dss-loris/prototype_1/PDF Schematics/Main.pdf

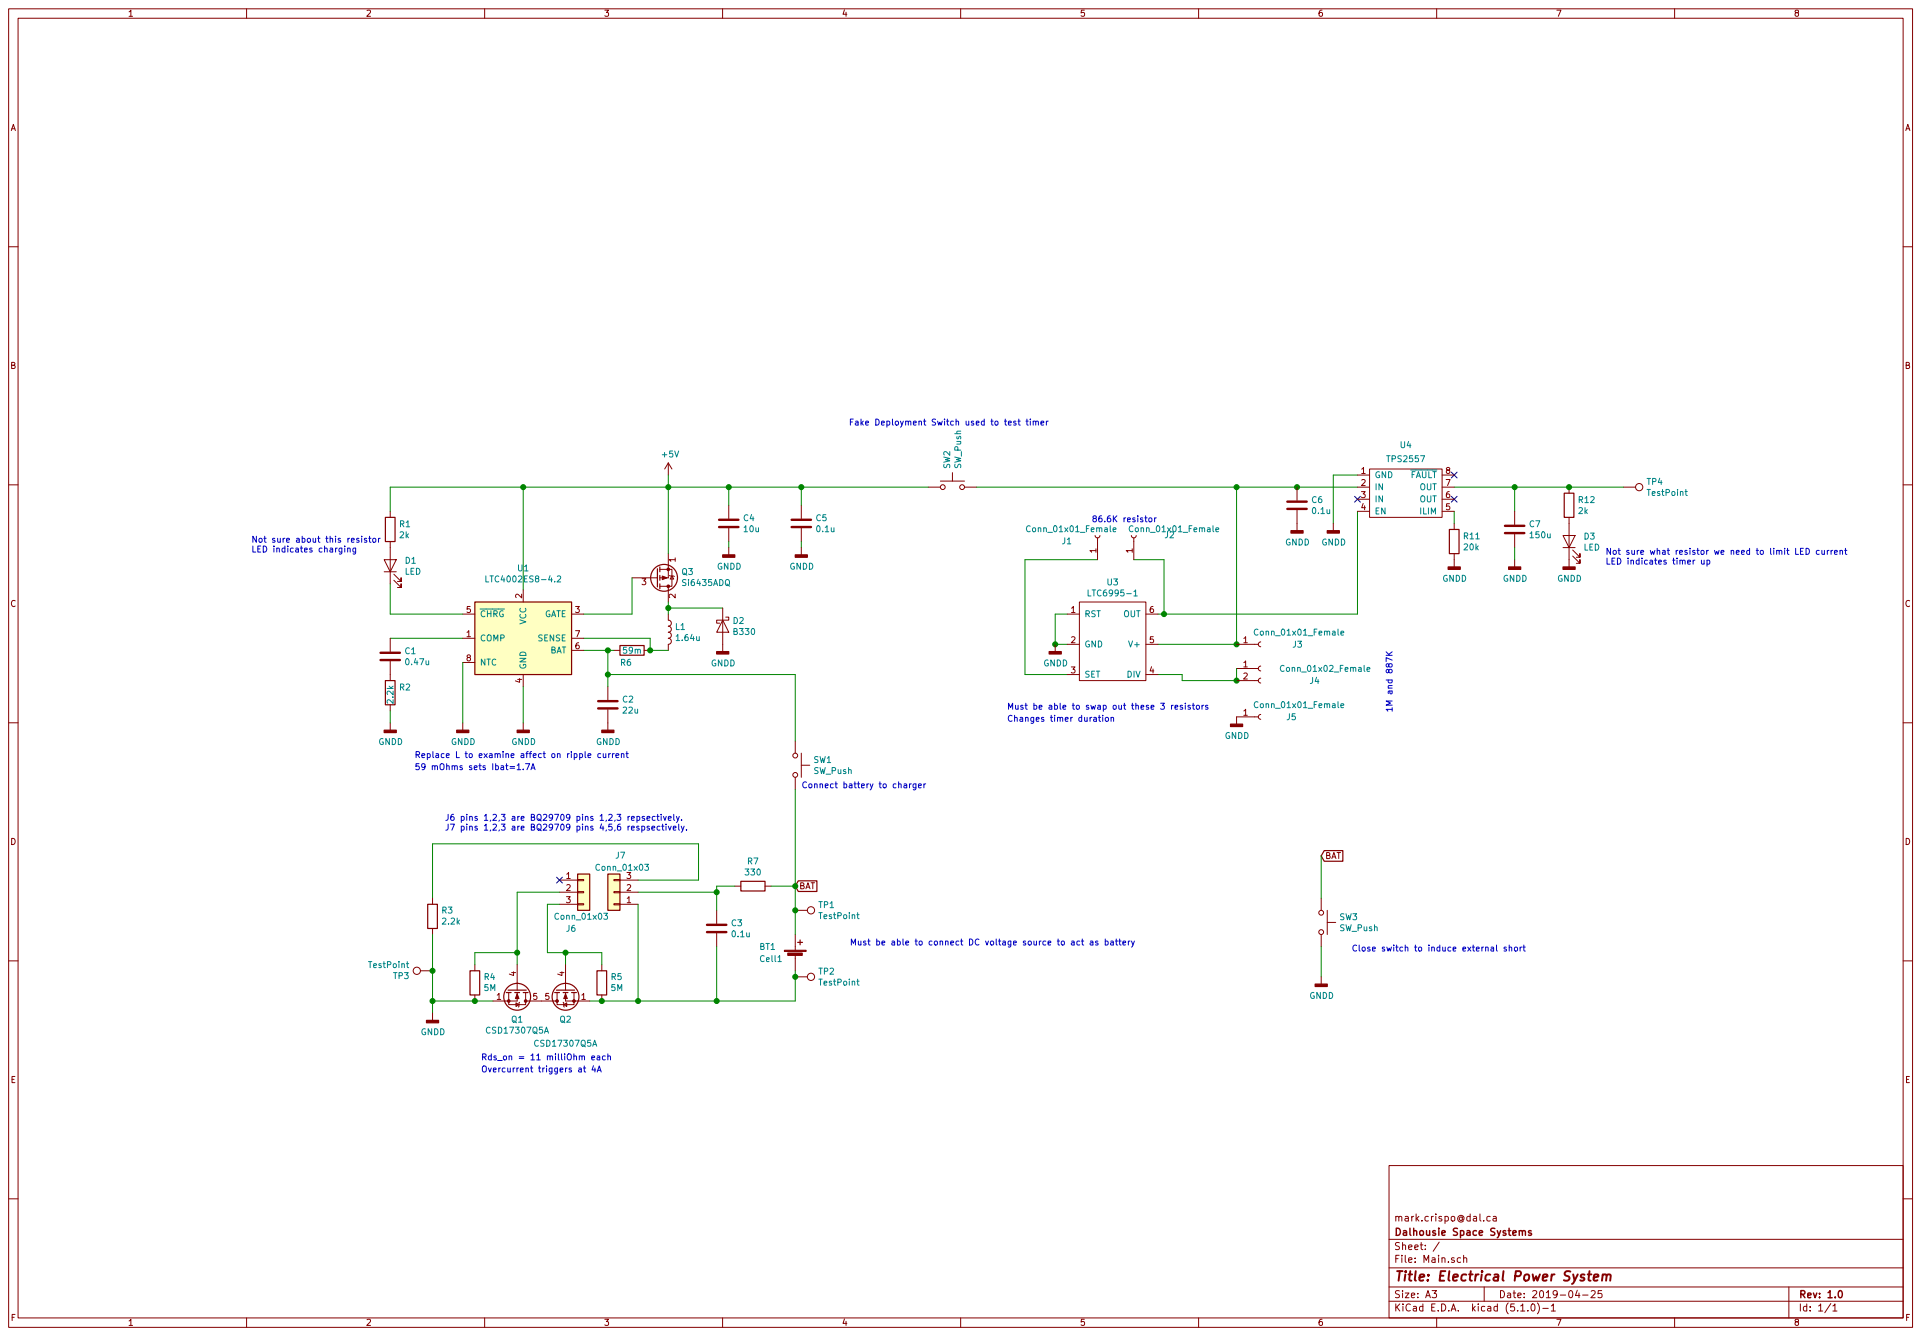
[picture p1: page 1]

LTC6995-1 Fake Deployment Switch used to test timer SW2 SW_Push

Not sure about this resistor LED indicates charging

4 CHRG 5 BAT 6 SENSE 7 NTC 8 U1

Replace L to examine affect on ripple current 59 mOhms sets Ibat=1.7A

Close switch to induce external short SW1 SW_Push Connect battery to charger

J6 pins 1,2,3 are BQ29709 pins 1,2,3 repsectively.

mark.crispo@dal.ca
File: Main.sch Sheet: / Dalhousie Space Systems

Id: 1/1 Title: Electrical Power System
