dss-loris/prototype_1/Main.kicad_pcb

## KiCad design Main.kicad_pcb (2019-07-02)

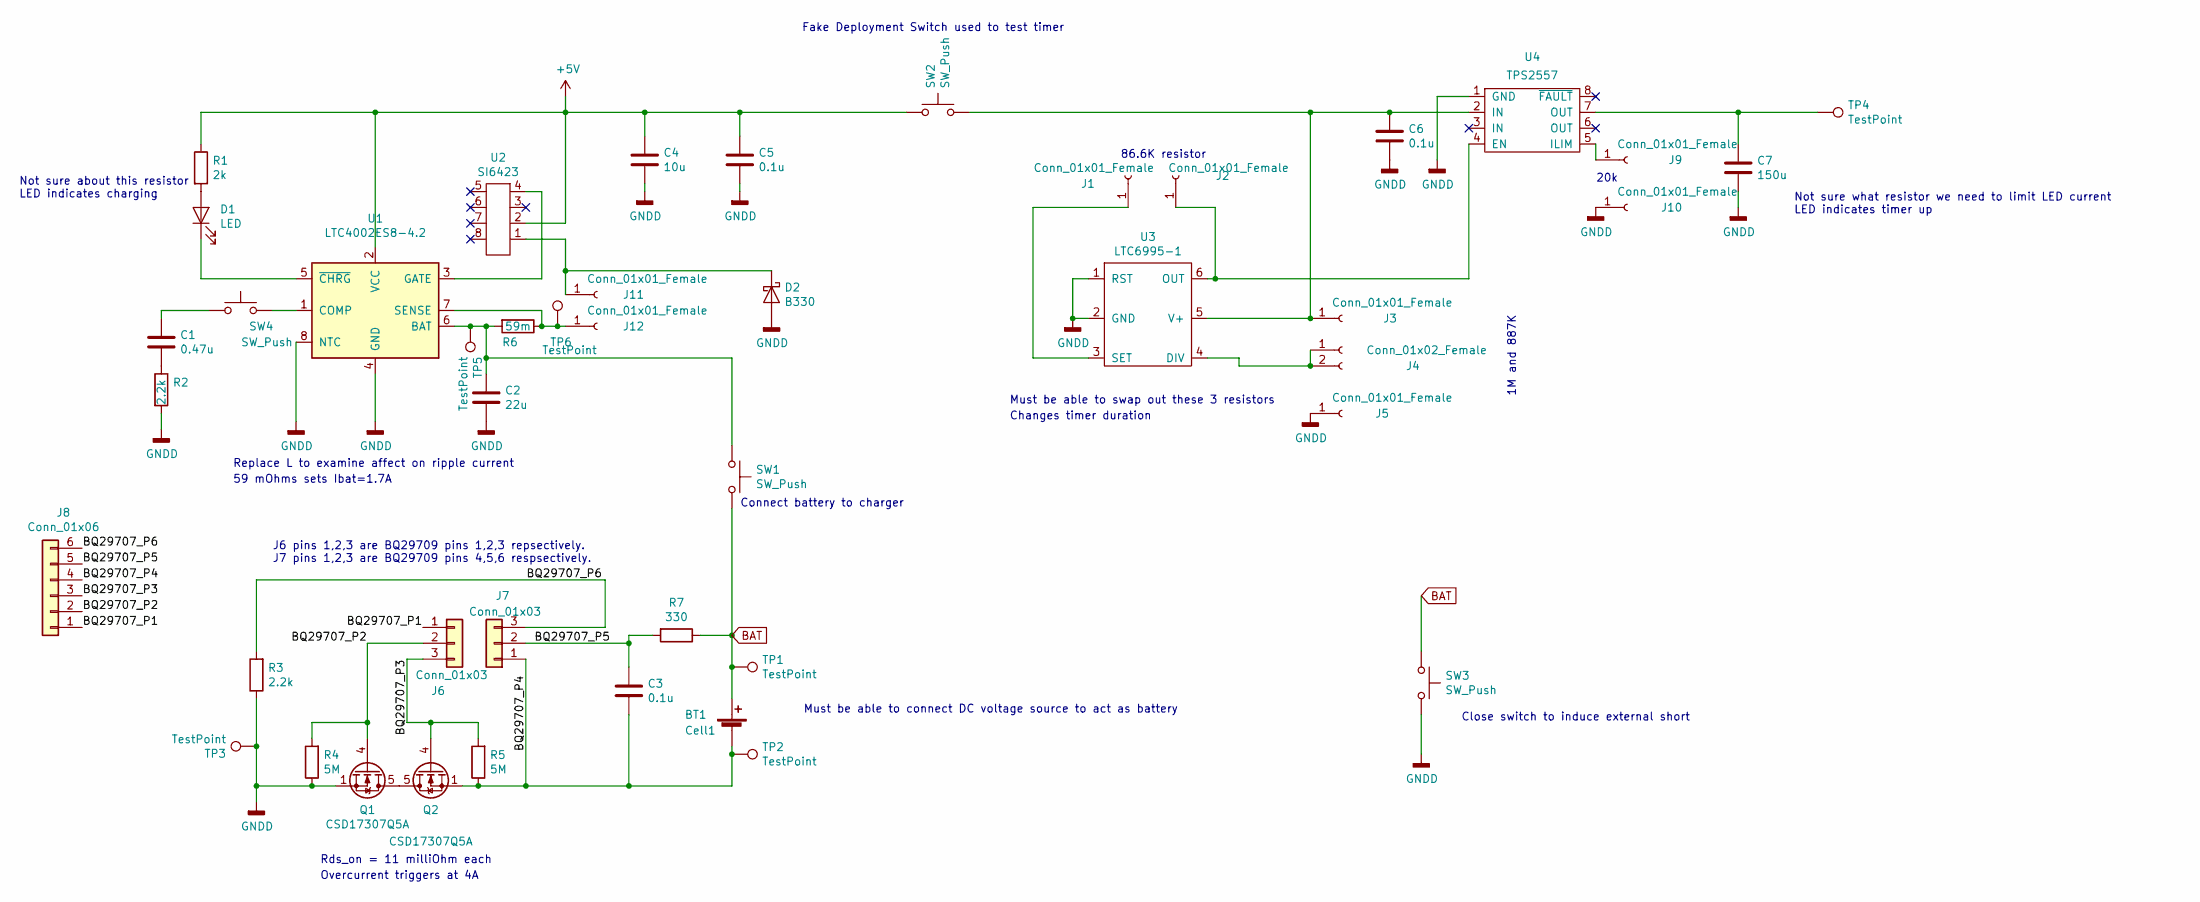
[picture p2: schematic Main.sch, Electrical Power System]

Parts:
BT1: Cell1; BatteryHolder_Keystone_1042_1x18650
C1: 0.47u; C_1206_3216Metric
C2: 22u; C_1206_3216Metric
C3, C5, C6: 0.1u; C_1206_3216Metric
C4: 10u; C_1206_3216Metric
C7: 150u; C_1206_3216Metric
D1: LED; LED_1206_3216Metric
D2: B330; D_SMC
J1, J2, J3, J5, J9, J10, J11, J12: Conn_01x01_Female; PinSocket_1x01_P2.00mm_Vertical
J4: Conn_01x02_Female; PinSocket_1x02_P2.00mm_Vertical
J6, J7: Conn_01x03; PinSocket_1x03_P2.54mm_Vertical
J8: Conn_01x06; PinHeader_1x06_P2.00mm_Vertical
Q1, Q2: CSD17307Q5A; TDSON-8-1
R1: 2k; R_1206_3216Metric
R2, R3: 2.2k; R_1206_3216Metric
R4, R5: 5M; R_1206_3216Metric
R6: 59m; R_1206_3216Metric
R7: 330; R_1206_3216Metric
SW1, SW2, SW3, SW4: SW_Push; SW_DIP_SPSTx01_Slide_6.7x4.1mm_W6.73mm_P2.54mm_LowProfile_J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
TP1, TP2, TP3, TP4, TP5, TP6: TestPoint; PinHeader_1x01_P2.00mm_Vertical
U1: LTC4002ES8-4.2; SOIC-8_3.9x4.9mm_P1.27mm
U2: SI6423; TSSOP-8_4.4x3mm_P0.65mm
U3: LTC6995-1; TSOT-23-6_HandSoldering
U4: TPS2557

Connections:
+5V: C4.1, C5.1, R1.1, SW2.1, U1.2 (VCC), U2.2
/BQ29707_P1: J6.1, J8.1
/BQ29707_P2: J6.2, J8.2, Q1.4 (G), R4.2
/BQ29707_P3: J6.3, J8.3, Q2.4 (G), R5.2
/BQ29707_P4: BT1.2 (-), C3.2, J7.1, J8.4, Q2.1 (S), Q2.2 (S), Q2.3 (S), R5.1, TP2.1
/BQ29707_P5: C3.1, J7.2, J8.5, R7.2
/BQ29707_P6: J7.3, J8.6, R3.2
BAT: BT1.1 (+), R7.1, SW1.2, SW3.1, TP1.1
GNDD: C2.2, C4.2, C5.2, C6.2, C7.2, D2.2 (A), J5.1, J10.1, Q1.1 (S), Q1.2 (S), Q1.3 (S), R2.2, R3.1, R4.1, SW3.2, TP3.1, U1.4 (GND), U1.8 (NTC), U3.1 (RST), U3.2 (GND), U4.1 (GND)
unnamed: C1.1, SW4.1
unnamed: C1.2, R2.1
unnamed: C2.1, R6.2, SW1.1, TP5.1, U1.6 (BAT)
unnamed: C6.1, J3.1, SW2.2, U3.5 (V+), U4.2 (IN)
unnamed: C7.1, TP4.1, U4.7 (OUT)
unnamed: D1.1 (K), U1.5 (~CHRG~)
unnamed: D1.2 (A), R1.2
unnamed: D2.1 (K), J11.1, U2.1
unnamed: J1.1, U3.3 (SET)
unnamed: J2.1, U3.6 (OUT), U4.4 (EN)
unnamed: J4.1, J4.2, U3.4 (DIV)
unnamed: J9.1, U4.5 (ILIM)
unnamed: J12.1, R6.1, TP6.1, U1.7 (SENSE)
unnamed: Q1.5 (D), Q2.5 (D)
unnamed: SW4.2, U1.1 (COMP)
unnamed: U1.3 (GATE), U2.4

Notes on the sheet:
Must be able to swap out these 3 resistors
Fake Deployment Switch used to test timer
Rds_on = 11 milliOhm each
Overcurrent triggers at 4A
Must be able to connect DC voltage source to act as battery
Close switch to induce external short
Connect battery to charger
Changes timer duration
Not sure what resistor we need to limit LED current LED indicates timer up
Not sure about this resistor LED indicates charging
Replace L to examine affect on ripple current
59 mOhms sets Ibat=1.7A
86.6K resistor
1M and 887K
J6 pins 1,2,3 are BQ29709 pins 1,2,3 repsectively. J7 pins 1,2,3 are BQ29709 pins 4,5,6 respsectively.
20k

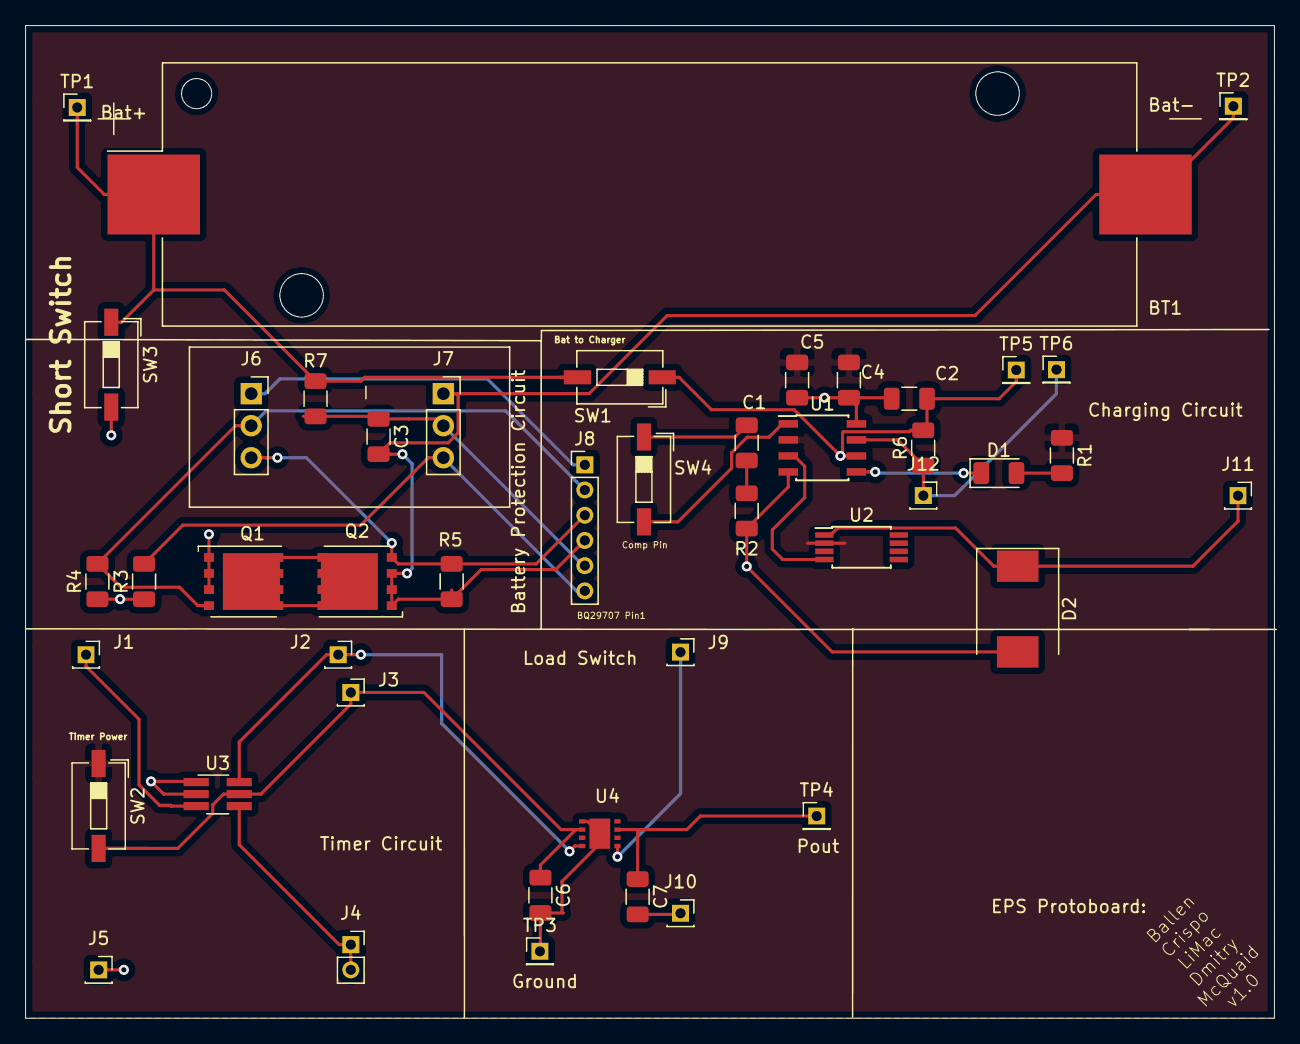
[picture p3: board Main.kicad_pcb from above]

Board: 2 copper layers, 99.1 x 78.7 mm, 45 parts (0 on the bottom side), 25 nets.
