dss-loris/prototype_1/(commit log)

2019-04-28 moved solar cell current sensor and load switch to root sheet
    [Main.sch, SPV1040.sch, SolarRegulator.sch]
2019-04-28 added schematic for Batt, BCR, and PDU
    [Main.sch, SPV1040.sch, SolarRegulator.sch]
2019-04-29 added current sensing circuit and 5v/3.3v voltage monitoring
    [Current Sesnsing.sch, Main.sch, SPV1040.sch, SolarRegulator.sch]
2019-05-13 Added libraries
    Addition of 555 & 4.2-5V Regulator libraries
2019-05-21 Imported 5V Regulator and 30 minute timer
    Added libraries to the working libraries in the main project. Also imported the 4.2-5VDC regulator and 30 minute timer schematics.
    [Main.sch, SPV1040.sch, SolarRegulator.sch]
2019-05-24 changed msp430
    [Current Sesnsing.sch, Low_pulser.sch, Main.sch, SPV1040.sch, SolarRegulator.sch]
2019-05-28 Added two more batteries for 4P configuration, added TI BQ297xx battery protection IC and PTC resettable fuse
    [BatteryCell.sch, Current Sesnsing.sch, Main.sch, SPV1040.sch, SolarRegulator.sch]
2019-05-29 added system switch to negative terminal of battery pack. moved BDR and BCR to hierarchical sheets for improved readability
    [BCR.sch, BDR.sch, Current Sesnsing.sch, Low_pulser.sch, Main.sch, SPV1040.sch, SolarRegulator.sch]
2019-05-31 Added more hierarchical sheets to improve readability, restructured the main schematic, and added ideal diode betewen BCR and BDR
    [3.3V_reg.sch, BatteryCell.sch, Current Sesnsing.sch, Low_pulser.sch, Main.sch, SPV1040.sch, SolarRegulator.sch]
2019-06-03 Added 5MOhm resistor across gatesource of power mosfet in battery cell protection schematic
    [BatteryCell.sch]
2019-06-05 rearranged op amps
    [BatteryCell.sch, Main.sch, SPV1040.sch]
2019-06-10 added new timer circuit and changed deployment switch architecture
    [3.3V_reg.sch, BCR.sch, BDR.sch, BatteryCell.sch, Current Sesnsing.sch, Main.sch, SPV1040.sch, SolarRegulator.sch]
2019-06-13 updated MOSFET model in battery cell protection schematic. Refused PTC fuse due to uncertain behaviour under conformal coating and in vacuum.
    [BatteryCell.sch]
2019-06-13 test commit
    [3.3V_reg.sch, BCR.sch, BDR.sch, BatteryCell.sch, Main.sch, SPV1040.sch, SolarRegulator.sch]
2019-06-17 started assigning footprints
    [Main.sch]
2019-06-17 added more footprints
    [Main.sch]
2019-06-18 need to add tps2557 footprint
    [Main.sch]
2019-06-19 started pcb
    [Main.kicad_pcb, Main.sch]
2019-06-19 finished traces
    [Main.kicad_pcb, Main.sch]
2019-06-21 allot a work
    [Main.kicad_pcb]
2019-06-21 still need breakout board for bq29707
    [Main.kicad_pcb, Main.sch]
2019-06-21 Finished, should be reviewed
    [Main-B_Cu.gbr, Main-B_Mask.gbr, Main-B_Paste.gbr, Main-B_SilkS.gbr, Main-Edge_Cuts.gbr, Main-F_Cu.gbr, Main-F_Mask.gbr, Main-F_Paste.gbr]
2019-06-24 added edge cut layer
    [Main-B_Cu.gbr, Main-B_Mask.gbr, Main-B_Paste.gbr, Main-B_SilkS.gbr, Main-Edge_Cuts.gbr, Main-F_Cu.gbr, Main-F_Mask.gbr, Main-F_Paste.gbr]
2019-06-24 reviewed footprints
    [Main-B_Cu.gbr, Main-B_Mask.gbr, Main-B_Paste.gbr, Main-B_SilkS.gbr, Main-Edge_Cuts.gbr, Main-F_Cu.gbr, Main-F_Mask.gbr, Main-F_Paste.gbr]
2019-06-24 added final silk comments
    [Main-B_Cu.gbr, Main-B_Mask.gbr, Main-B_Paste.gbr, Main-B_SilkS.gbr, Main-Edge_Cuts.gbr, Main-F_Cu.gbr, Main-F_Mask.gbr, Main-F_Paste.gbr]
2019-06-24 added changes mark wante
    [Main-B_Cu.gbr, Main-B_Mask.gbr, Main-B_Paste.gbr, Main-B_SilkS.gbr, Main-Edge_Cuts.gbr, Main-F_Cu.gbr, Main-F_Mask.gbr, Main-F_Paste.gbr]
2019-06-24 changes for BOM
    [Main-B_Cu.gbr, Main-B_Mask.gbr, Main-B_Paste.gbr, Main-B_SilkS.gbr, Main-Edge_Cuts.gbr, Main-F_Cu.gbr, Main-F_Mask.gbr, Main-F_Paste.gbr]
2019-06-24 regenerated gerbers
    [Main-B_Cu.gbr, Main-B_Mask.gbr, Main-B_Paste.gbr, Main-B_SilkS.gbr, Main-Edge_Cuts.gbr, Main-F_Cu.gbr, Main-F_Mask.gbr, Main-F_Paste.gbr]
2019-07-02 changed transistor
    [Main-B_Cu.gbr, Main-B_Mask.gbr, Main-B_Paste.gbr, Main-B_SilkS.gbr, Main-Edge_Cuts.gbr, Main-F_Cu.gbr, Main-F_Mask.gbr, Main-F_Paste.gbr]
